pchartrand/temperature-monitor/Samples/temperature_monitor_diagram.png

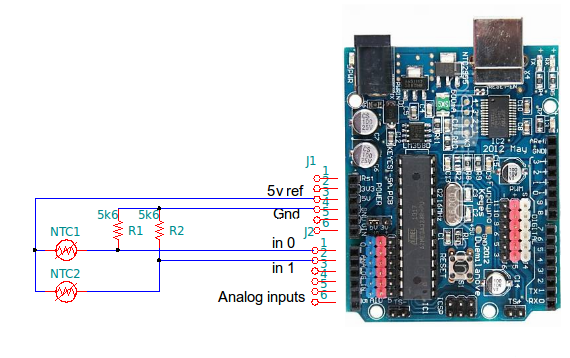
Samples/temperature_monitor_diagram.png
