pchartrand/temperature-monitor/Samples/temperatures_2014-11-09_12:00:02.png

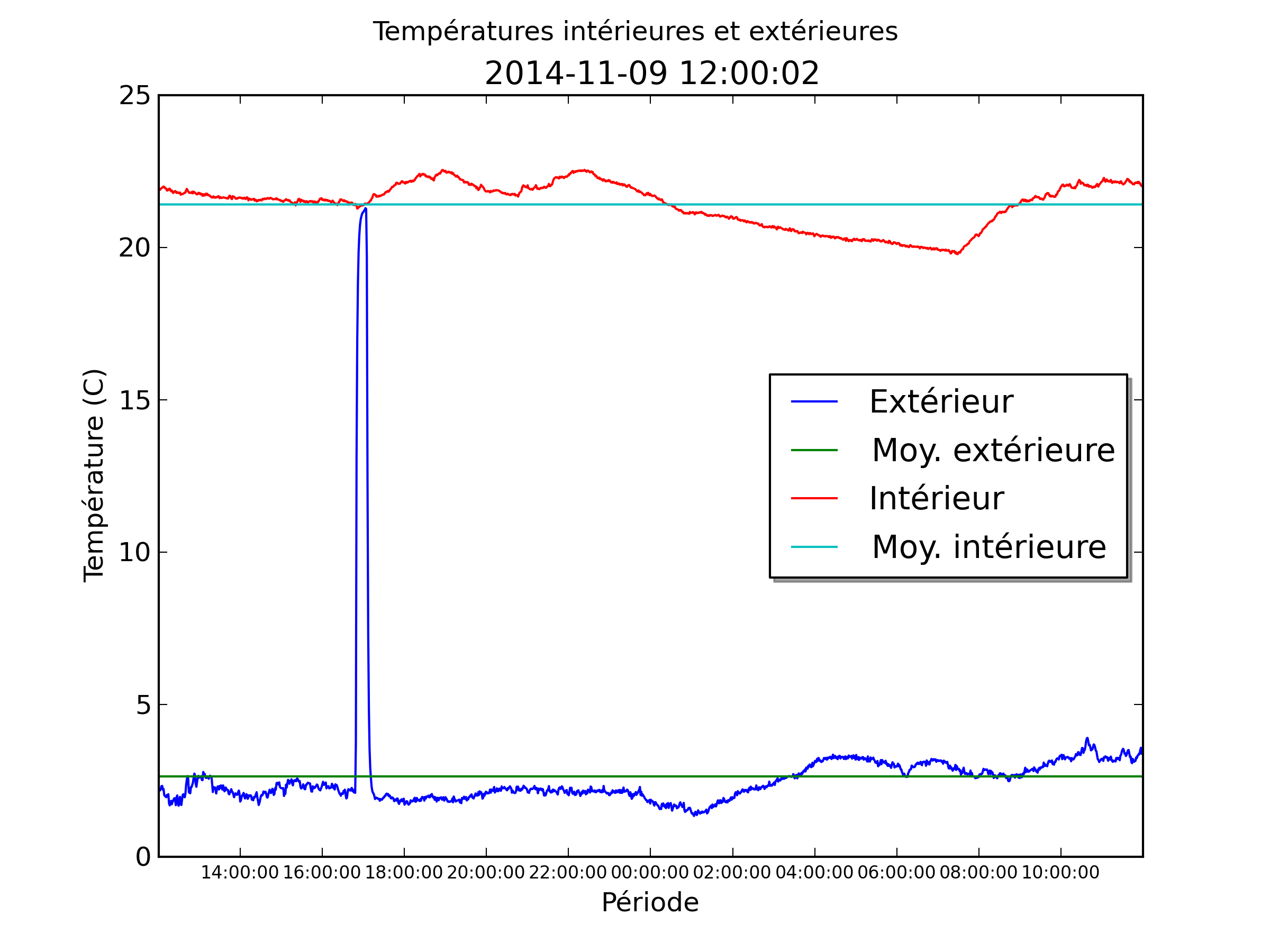
Samples/temperatures_2014-11-09_12:00:02.png
