pchartrand/temperature-monitor/Samples/temperatures_2015-04-21_06:00:08.png

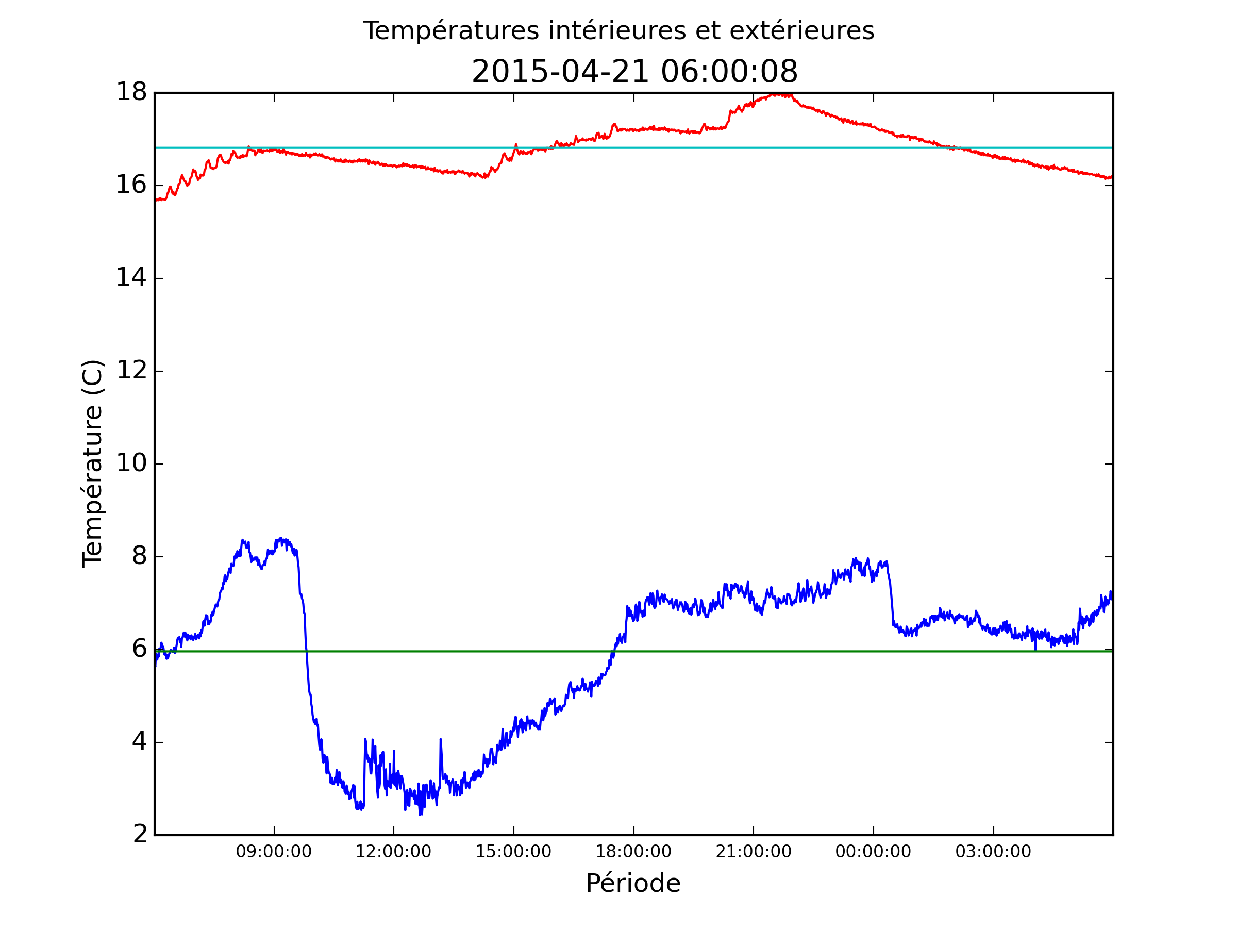
Samples/temperatures_2015-04-21_06:00:08.png
