pchartrand/temperature-monitor/Samples/temperatures_2015-06-07_00:00:10.png

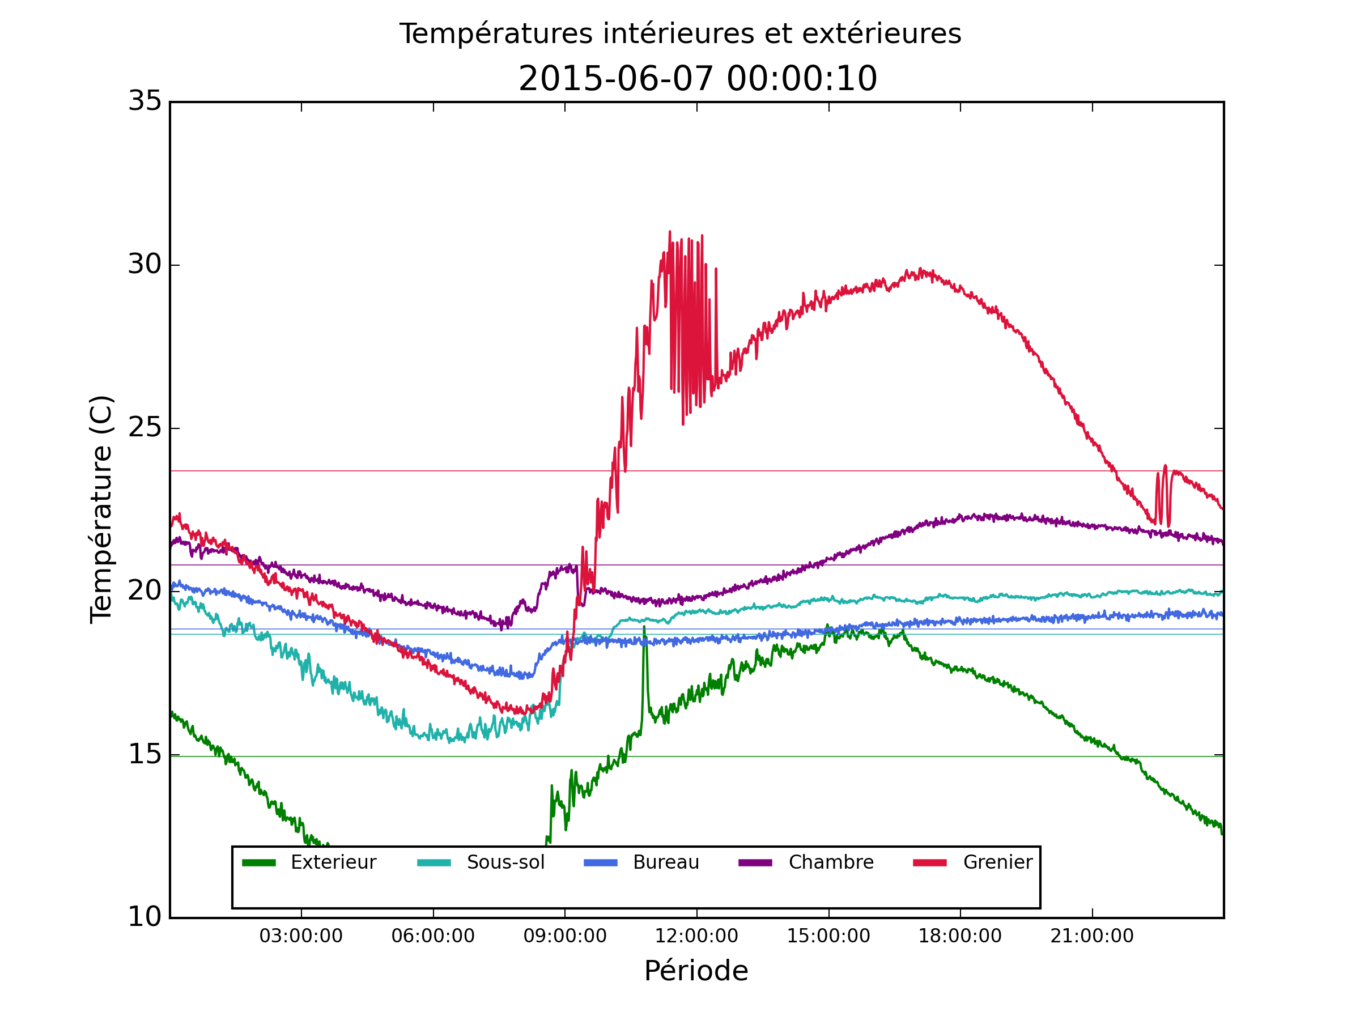
Samples/temperatures_2015-06-07_00:00:10.png
