pchartrand/temperature-monitor/Samples/temperatures_2015-11-01_12:00:12.png

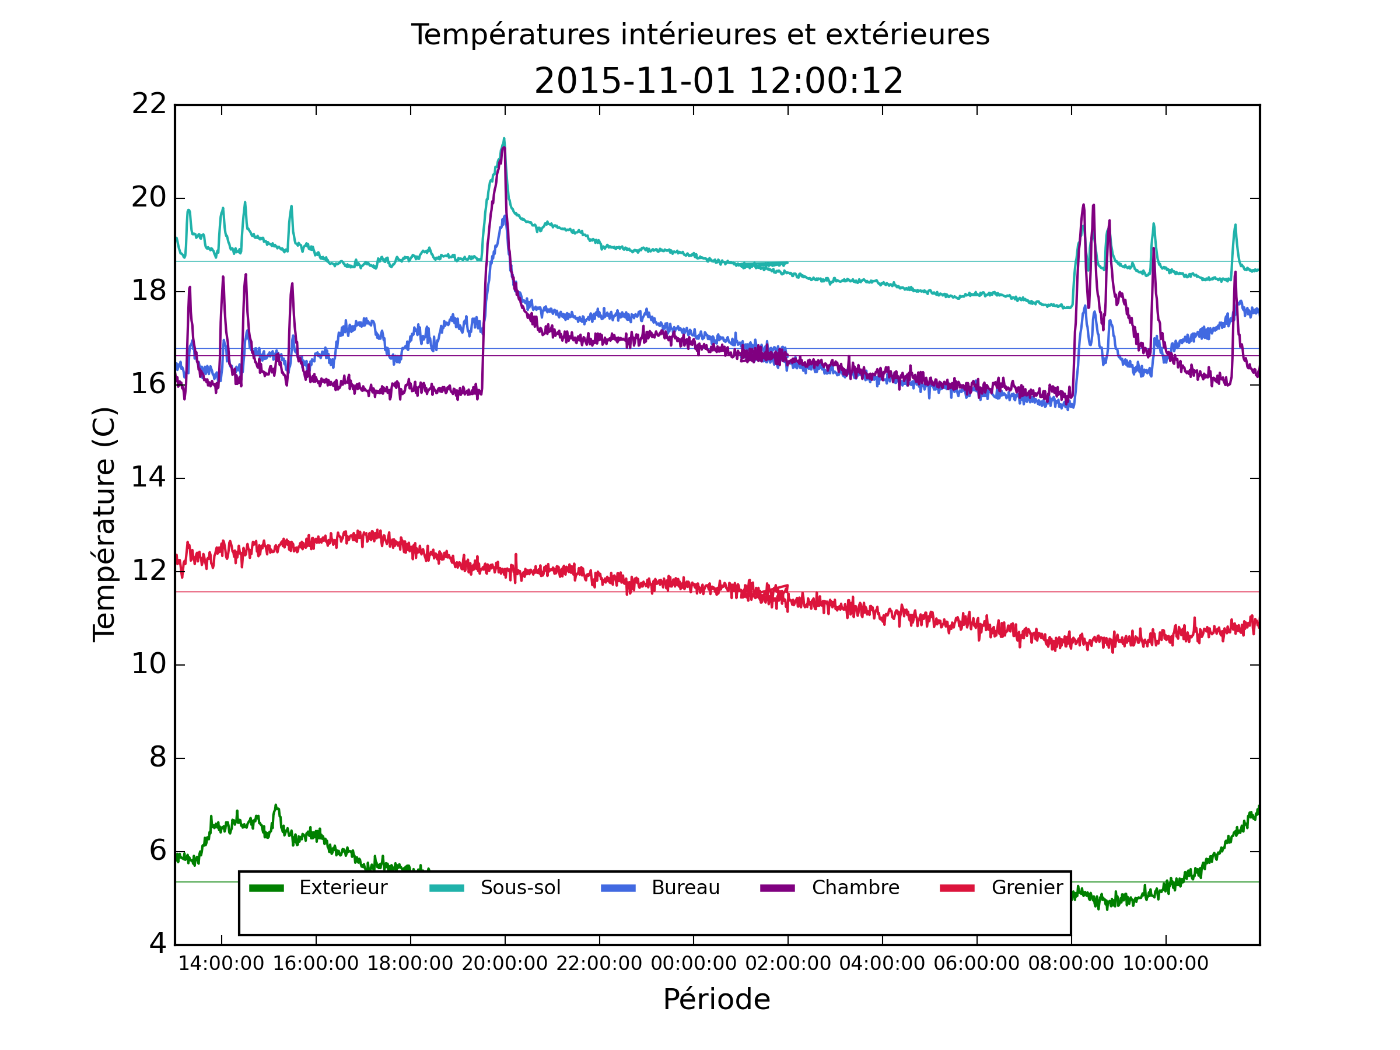
Samples/temperatures_2015-11-01_12:00:12.png
