pchartrand/temperature-monitor/Samples/ntc_measurements_and_polynomial_regression.png

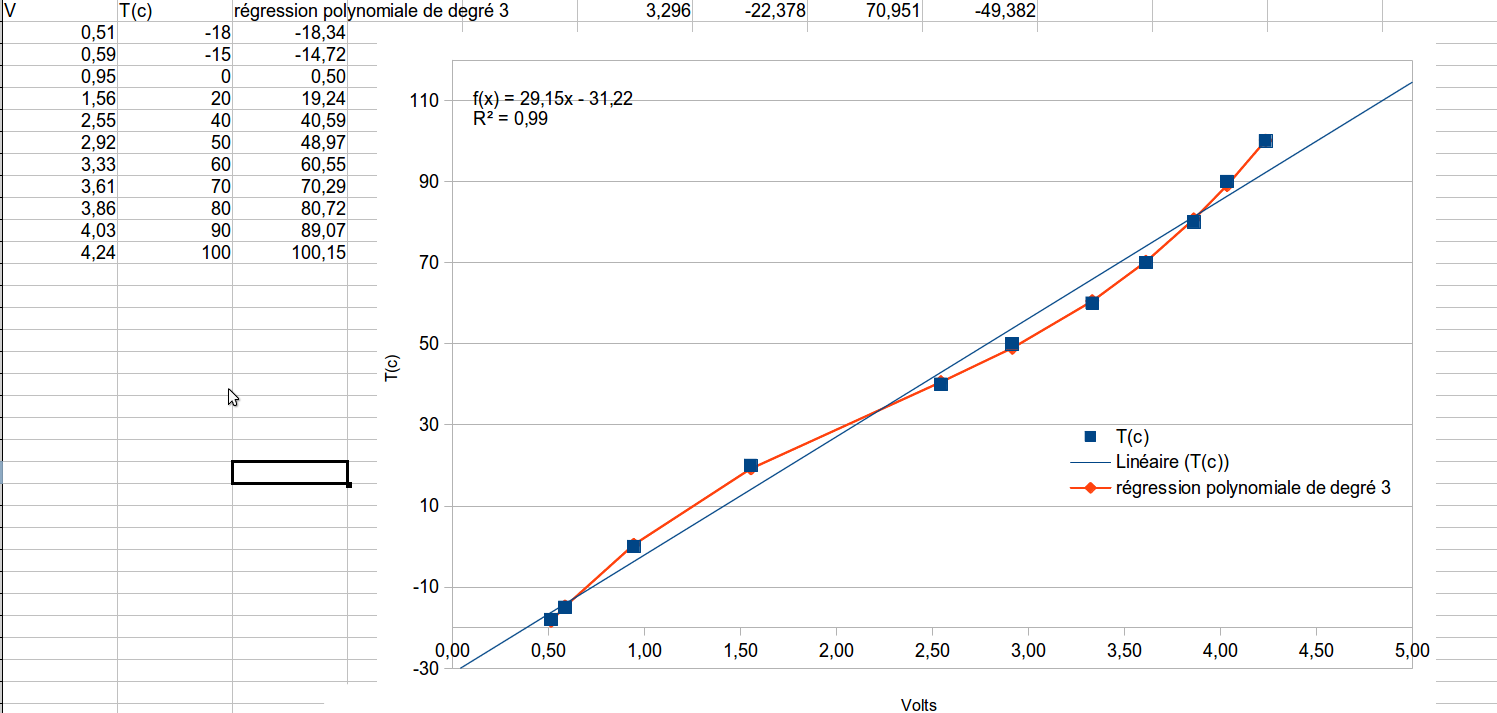
Samples/ntc_measurements_and_polynomial_regression.png
