pchartrand/temperature-monitor/(commit log)

2014-11-09 Added docstrings. allow limiting number of samples in StoreSeriesFetcher().fetch()
2014-11-09 renamed ARDUINO_BAUD_RATE constant, check for known line names
2014-11-10 protection of store against negative indices, update counter when inserting at arbitrary positions
2014-11-11 Added arduino sketchbook, completed README.
2014-11-11 Updated README for table formatting. Added sample graph.
2014-11-12 added schematic diagram
2014-11-12 minor correction to schematic diagram
2014-11-12 Added references to Sample diagrams
2014-12-26 added temperature variation calculation methods
2015-01-04 empty print line
2015-04-29 adjust sample window to number of inputs
2015-05-29 set average temperature color line same as temperature color
2015-11-07 5 inputs temperature monitor
2015-11-08 display volts/farenheit value with buttons, blank after 20 seconds
2015-11-12 samples of temperature measurements spring, summer and fall
2016-03-17 setup with an arduino in the same watch box
2016-05-12 allow to sub-sample or smooth time series
2016-05-12 attribute average to most recent timestamp of sampled timestamps
2016-06-12 revert to 5 inputs
    [temperature_monitor_with_lcd_display.ino]
